adeandak/taximetro/README.md

# taximetro
Codigo y documentacion de la implementacion de un taximetro dinamico.
