adeandak/taximetro/__latexindent_temp.tex

% Template for documenting your Arduino projects
% Author:   Luis José Salazar-Serrano
%           totesalaz@gmail.com / luis-jose.salazar@icfo.es
%           http://opensourcelab.salazarserrano.com

%%% Template based in the template created by Karol Kozioł (mail@karol-koziol.net)

\documentclass[a4paper,11pt]{article}

\usepackage[T1]{fontenc}
\usepackage[utf8]{inputenc}
\usepackage{graphicx}
\usepackage{xcolor}

\renewcommand\familydefault{\sfdefault}
\usepackage{tgheros}
\usepackage[defaultmono]{droidmono}

\usepackage{amsmath,amssymb,amsthm,textcomp}
\usepackage{enumerate}
\usepackage{multicol}
\usepackage{tikz}
\usepackage{courier}

\usepackage{geometry}
\geometry{total={210mm,297mm},
left=25mm,right=25mm,%
bindingoffset=0mm, top=20mm,bottom=20mm}

\linespread{1.3}

\newcommand{\linia}{\rule{\linewidth}{0.5pt}}

% my own titles
\makeatletter
\renewcommand{\maketitle}{
\begin{center}
\vspace{2ex}
{\huge \textsc{\@title}}
\vspace{1ex}
\\
\linia\\
\@author \hfill \@date
\vspace{4ex}
\end{center}
}
\makeatother
%%%

% custom footers and headers
\usepackage{fancyhdr}
\pagestyle{fancy}
\lhead{}
\chead{}
\rhead{}
\lfoot{Arduino Blink Example}
\cfoot{}
\rfoot{Page \thepage}
\renewcommand{\headrulewidth}{0pt}
\renewcommand{\footrulewidth}{0pt}
%

% code listing settings
\usepackage{listings}

\lstset{%
  language = Octave,
  backgroundcolor=\color{white},   
  basicstyle=\footnotesize\ttfamily,       
  breakatwhitespace=false,         
  breaklines=true,                 
  captionpos=b,                   
  commentstyle=\color{gray},    
  deletekeywords={...},           
  escapeinside={\%*}{*)},          
  extendedchars=true,              
  frame=single,                    
  keepspaces=true,                 
  keywordstyle=\color{orange},       
  morekeywords={*,...},            
  numbers=left,                    
  numbersep=5pt,                   
  numberstyle=\footnotesize\color{gray}, 
  rulecolor=\color{black},         
  rulesepcolor=\color{blue},
  showspaces=false,                
  showstringspaces=false,          
  showtabs=false,                  
  stepnumber=2,                    
  stringstyle=\color{orange},    
  tabsize=2,                       
  title=\lstname,
  emphstyle=\bfseries\color{blue}%  style for emph={} 
} 

%% language specific settings:
\lstdefinestyle{Arduino}{%
    language = Octave,
    keywords={void, int boolean},%                 define keywords
    morecomment=[l]{//},%             treat // as comments
    morecomment=[s]{/*}{*/},%         define /* ... */ comments
    emph={HIGH, OUTPUT, LOW}%        keywords to emphasize
}

%%%----------%%%----------%%%----------%%%----------%%%

\begin{document}

\title{Documenting Your Arduino Code}

\author{Andrea de Anda Kuri Silvestre Leonardo Gonzalez Abreu}

\date{11/11/2019}

\maketitle

\section*{Circuit}
Lorem ipsum dolor sit amet, consectetur adipiscing elit, sed do eiusmod tempor incididunt ut labore et dolore magna aliqua. Ut enim ad minim veniam, quis nostrud exercitation ullamco laboris nisi ut aliquip ex ea commodo consequat. 

\begin{figure}[h]
\centering
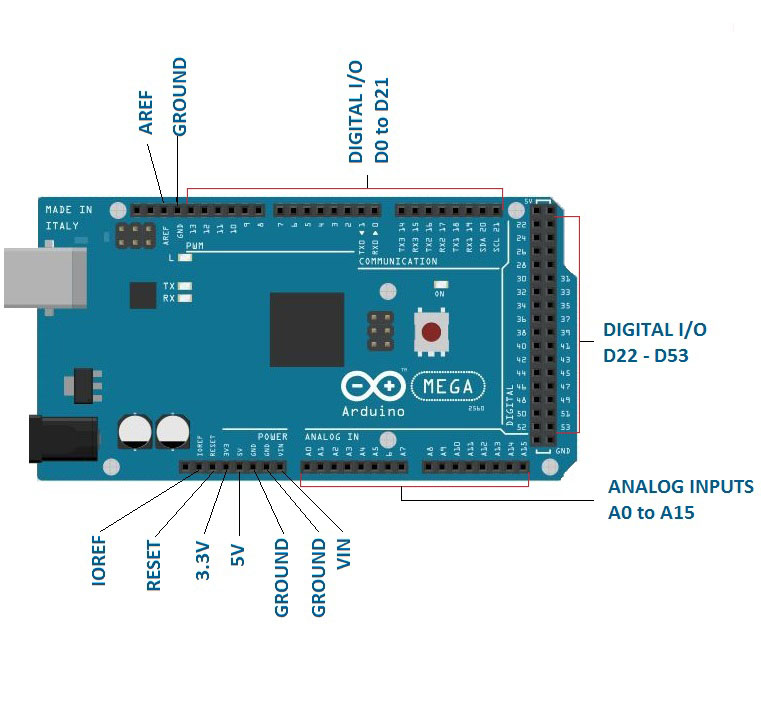
[picture p1: Arduino.jpg]

\caption{Circuit description.}
\end{figure}

Duis aute irure dolor in reprehenderit in voluptate velit esse cillum dolore eu fugiat nulla pariatur.
Excepteur sint occaecat cupidatat non proident, sunt in culpa qui officia deserunt mollit anim id est laborum.

\section*{Code Description by Line}
Lorem ipsum dolor sit amet, consectetur adipiscing elit, sed do eiusmod tempor incididunt ut labore et dolore magna aliqua. Ut enim ad minim veniam, quis nostrud exercitation ullamco laboris nisi ut aliquip ex ea commodo consequat. Duis aute irure dolor in reprehenderit in voluptate velit esse cillum dolore eu fugiat nulla pariatur. Excepteur sint occaecat cupidatat non proident, sunt in culpa qui officia deserunt mollit anim id est laborum.

\section*{Arduino Code}
Following Listing~\ref{list:first}\ldots{} 
Lorem ipsum dolor sit amet, consectetur adipiscing elit, sed do eiusmod tempor incididunt ut labore et dolore magna aliqua. Ut enim ad minim veniam, quis nostrud exercitation ullamco laboris nisi ut aliquip ex ea commodo consequat. Duis aute irure dolor in reprehenderit in voluptate velit esse cillum dolore eu fugiat nulla pariatur. Excepteur sint occaecat cupidatat non proident, sunt in culpa qui officia deserunt mollit anim id est laborum.

\subsection*{Write the code in lstlisting}

\begin{lstlisting}[label={list:first}, style=Arduino, caption=Blink.ino]
/*
  Blink
  Turns on an LED on for one second, then off for one second, repeatedly.

  Most Arduinos have an on-board LED you can control. On the Uno and
  Leonardo, it is attached to digital pin 13. If you're unsure what
  pin the on-board LED is connected to on your Arduino model, check
  the documentation at http://arduino.cc

  This example code is in the public domain.

  modified 8 May 2014
  by Scott Fitzgerald
 */

// the setup function runs once when you press reset or power the board
void setup() {
  // initialize digital pin 13 as an output.
  pinMode(13, OUTPUT);
}

// the loop function runs over and over again forever
void loop() {
  digitalWrite(13, HIGH);   // turn the LED on (HIGH is the voltage level)
  delay(1000);              // wait for a second
  digitalWrite(13, LOW);    // turn the LED off by making the voltage LOW
  delay(1000);              // wait for a second
}
\end{lstlisting}

Lorem ipsum dolor sit amet, consectetur adipiscing elit, sed do eiusmod tempor incididunt ut labore et dolore magna aliqua. Ut enim ad minim veniam, quis nostrud exercitation ullamco laboris nisi ut aliquip ex ea commodo consequat. Duis aute irure dolor in reprehenderit in voluptate velit esse cillum dolore eu fugiat nulla pariatur. Excepteur sint occaecat cupidatat non proident, sunt in culpa qui officia deserunt mollit anim id est laborum.

\subsection*{Take code directly from *.ino file}
Lorem ipsum dolor sit amet, consectetur adipiscing elit, sed do eiusmod tempor incididunt ut labore et dolore magna aliqua. Ut enim ad minim veniam, quis nostrud exercitation ullamco laboris nisi ut aliquip ex ea commodo consequat. 

% \lstinputlisting[style=Arduino]{Blink.ino}

Duis aute irure dolor in reprehenderit in voluptate velit esse cillum dolore eu fugiat nulla pariatur. Excepteur sint occaecat cupidatat non proident, sunt in culpa qui officia deserunt mollit anim id est laborum.

\end{document}
