adeandak/taximetro/images/maq1.png

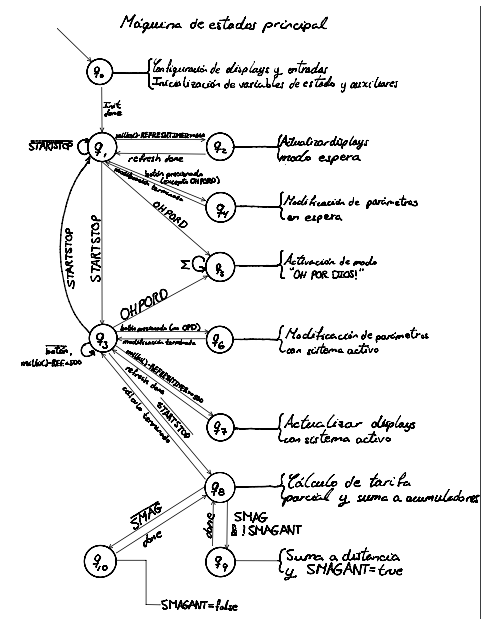
images/maq1.png
