adeandak/taximetro/images/Maq Taxi/page1.jpg

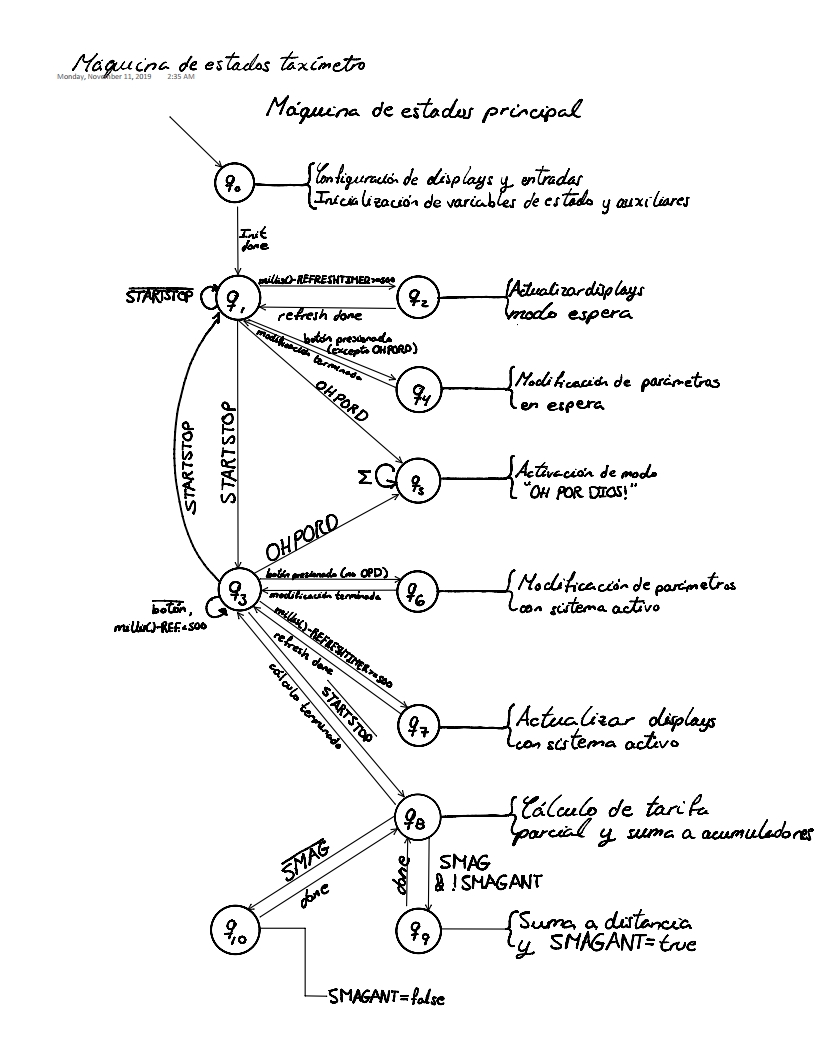
images/Maq Taxi/page1.jpg
