adeandak/taximetro/images/Maq Taxi/page2.jpg

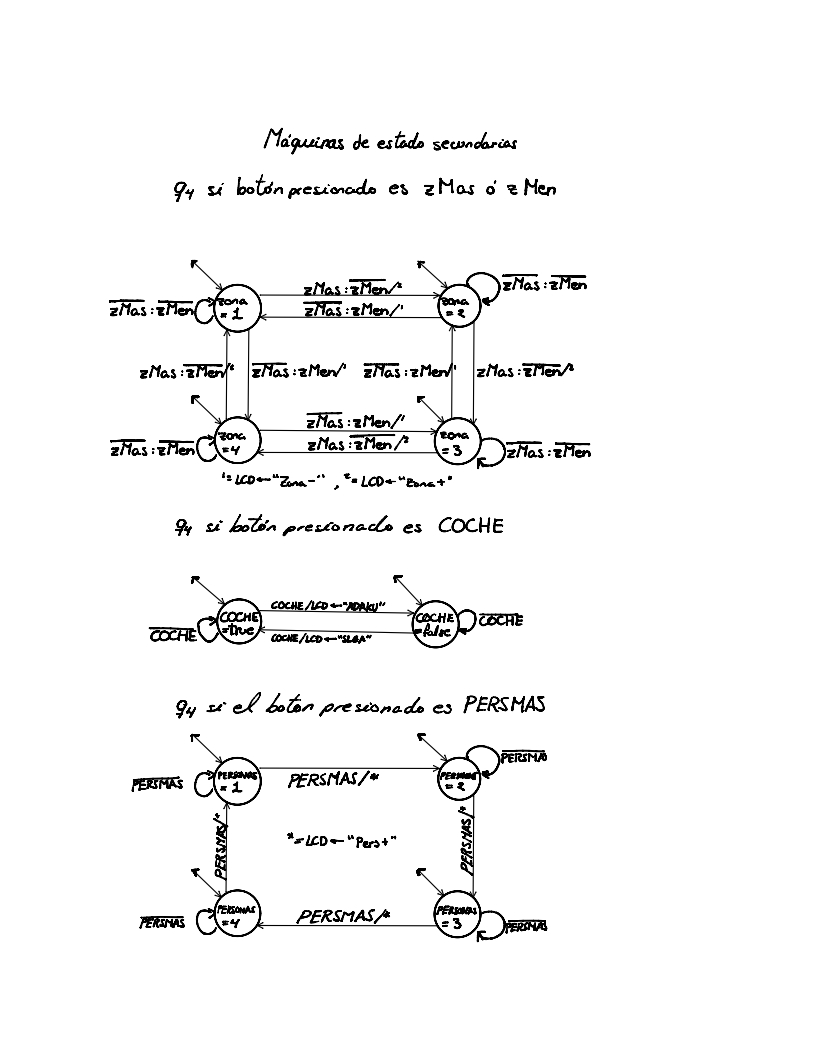
images/Maq Taxi/page2.jpg
