adeandak/taximetro/images/Maq Taxi/page3.jpg

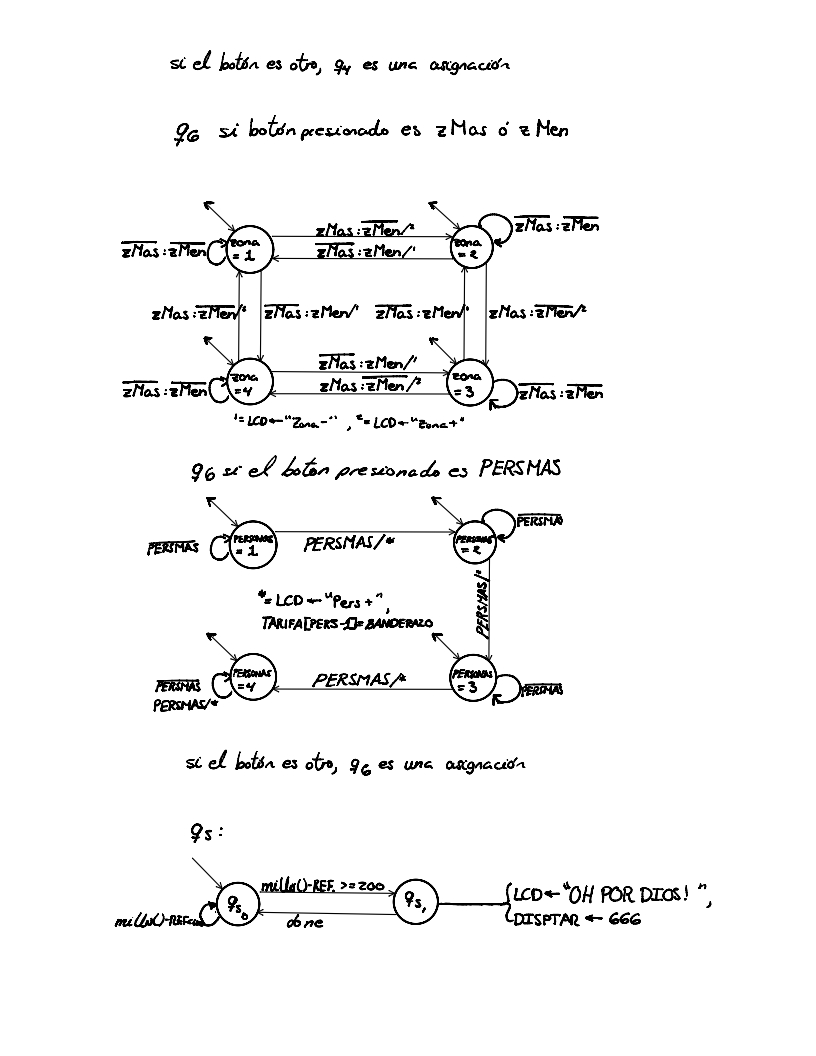
images/Maq Taxi/page3.jpg
