adeandak/taximetro/images/taximetro.jpg

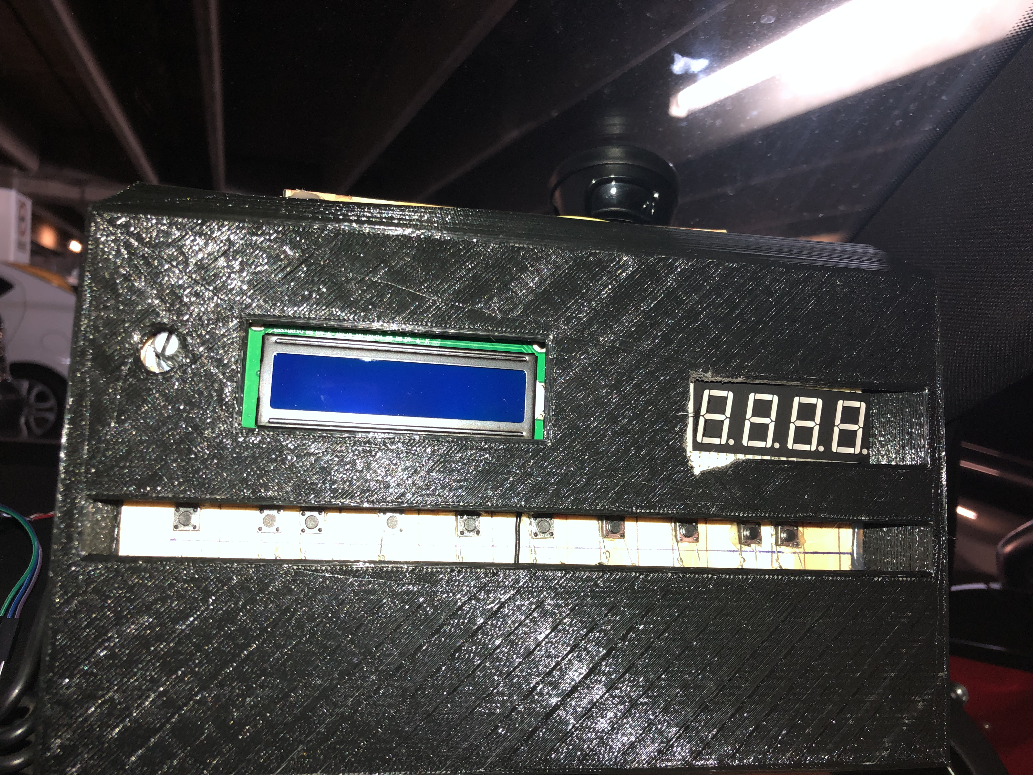
[picture p9: images/taximetro.jpg]
images/taximetro.jpg
